vladbelous/pcb-lab-1/assembly/jlcpcb-pcb-lab-1-BOM.xlsx

Designator | Footprint | Quantity | Value | LCSC Part #
C1 | 805 | 1 | 10u | C15850
C2,C3,C4,C6,C7,C10,C11,C12,C13,C14,C15,C20,C21,C30,C31 | 603 | 15 | 100n | C14663
C5,C8 | 805 | 2 | 1u | C28323
D1 | LED_0805 | 1 | RED | C84256
D2 | LED_0805 | 1 | YEL | C2296
D3 | LED_0805 | 1 | GRN | C2297
Q30,Q31 | SOT-23-3 | 2 | NMOS_GSD | C8545
R1,R2,R3 | 805 | 3 | 1k | C17513
R4,R20 | 603 | 2 | 3.3k | C22978
R5,R6,R7,R30,R31,R32,R33 | 603 | 7 | 10k | C25804
R8,R9 | 603 | 2 | 100k | C25803
