vladbelous/pcb-lab-1/pcb-lab-1.pdf

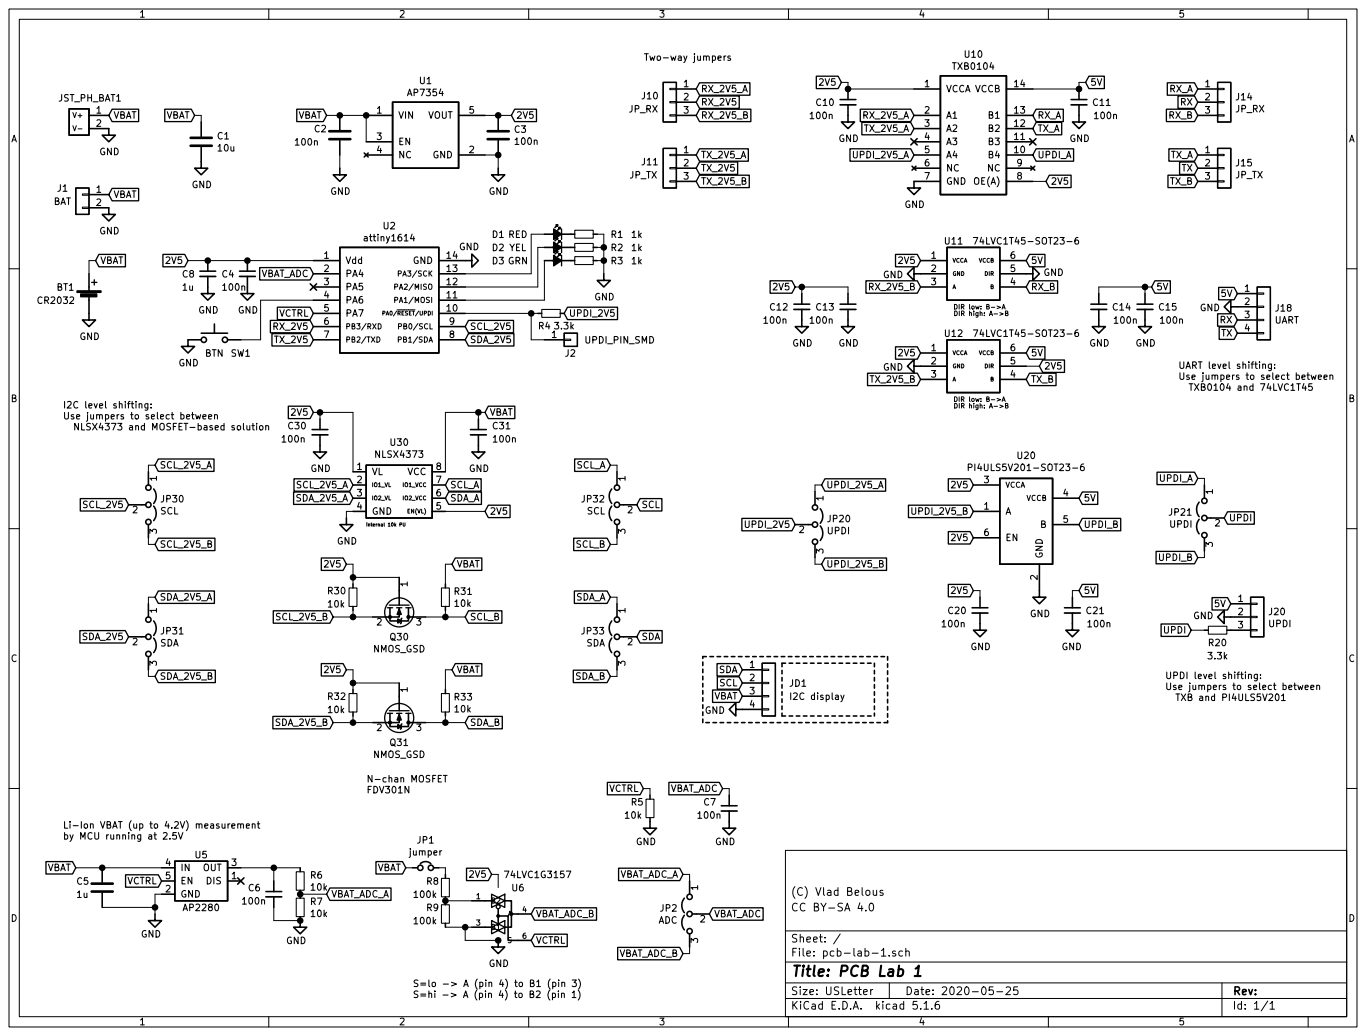
[picture p2: page 1]

DIR high: A->B DIR low: B->A

UART level shifting:
Use jumpers to select between
TXB0104 and 74LVC1T45

I2C level shifting:
NLSX4373 and MOSFET-based solution

TXB and PI4ULS5V201

S=hi -> A (pin 4) to B2 (pin 1) N-chan MOSFET
FDV301N

Li-Ion VBAT (up to 4.2V) measurement
by MCU running at 2.5V

(C) Vlad Belous File: pcb-lab-1.sch Sheet: / CC BY-SA 4.0

Rev: | D Date: 2020-05-25 KiCad E.D.A. kicad 5.1.6 Size: USLetter

Id: 1/1 Title: PCB Lab 1

S=lo -> A (pin 4) to B1 (pin 3)
