vladbelous/pcb-lab-1/pcb-lab-1.kicad_pcb

## KiCad design pcb-lab-1.kicad_pcb (2020-06-13)

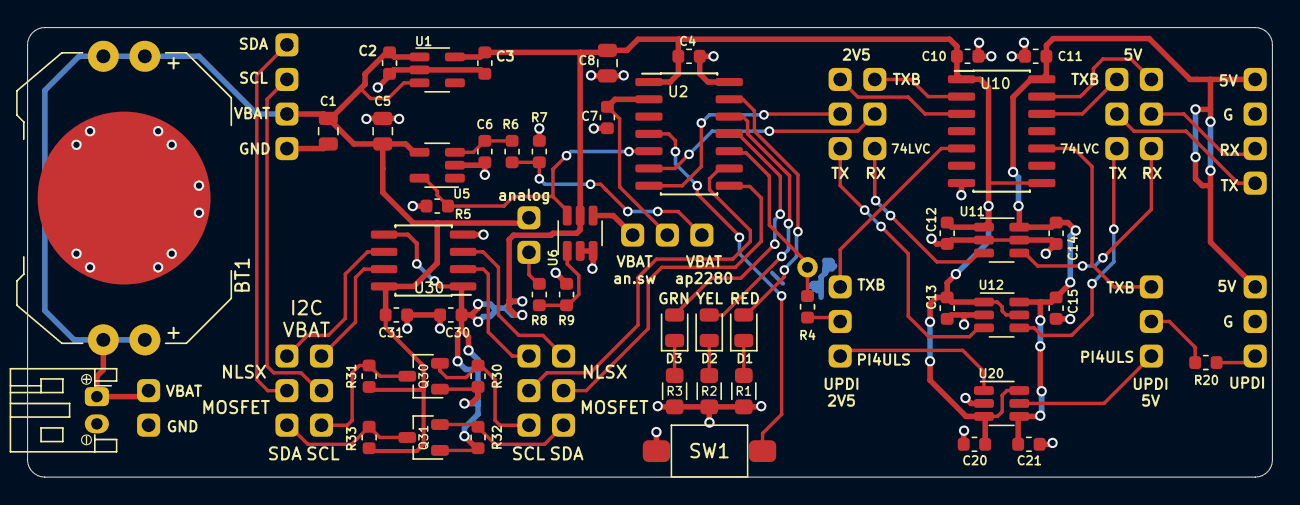
[picture p3: board pcb-lab-1.kicad_pcb from above]

Board: 2 copper layers, 91.4 x 33.0 mm, 66 parts (0 on the bottom side), 50 nets.

Parts:
BT1: CR2032; CR2032_Holder_Linx
C1: 10u; C_0805_2012Metric
C2, C3, C4, C6, C7, C10, C11, C12, C13, C14, C15, C20, C21, C30, C31: 100n; C_0603_1608Metric
C5, C8: 1u; C_0805_2012Metric
D1: RED; LED_0805_2012Metric
D2: YEL; LED_0805_2012Metric
D3: GRN; LED_0805_2012Metric
J1: BAT; Pin_Header_Straight_1x02_Pitch2.54mm
J2: UPDI_PIN_SMD; Conn_1-wire
J10, J14: JP_RX; Pin_Header_Straight_1x03_Pitch2.54mm
J11, J15: JP_TX; Pin_Header_Straight_1x03_Pitch2.54mm
J18: UART; Pin_Header_Straight_1x04_Pitch2.54mm
J20: UPDI; Pin_Header_Straight_1x03_Pitch2.54mm
JD1: I2C display; Pin_Header_Straight_1x04_Pitch2.54mm
JP1: jumper; Pin_Header_Straight_1x02_Pitch2.54mm
JP2: ADC; Pin_Header_Straight_1x03_Pitch2.54mm
JP20, JP21: UPDI; Pin_Header_Straight_1x03_Pitch2.54mm
JP30, JP32: SCL; Pin_Header_Straight_1x03_Pitch2.54mm
JP31, JP33: SDA; Pin_Header_Straight_1x03_Pitch2.54mm
JST_PH_BAT1: JST_PH_BAT; JST_PH_S2B-PH-K_02x2.00mm_Angled_WiderHole
Q30, Q31: NMOS_GSD; SOT-23_HS
R1, R2, R3: 1k; 0805_HS
R4, R20: 3.3k; R_0603_1608Metric
R5, R6, R7, R30, R31, R32, R33: 10k; R_0603_1608Metric
R8, R9: 100k; R_0603_1608Metric
SW1: BTN; SW_SPST_PUSH_6mm_3mm
U1: AP7354; SOT-23-5_HS
U2: attiny1614; SOIC-14_3.9x8.7mm_Pitch1.27mm_HS
U5: AP2280; SOT-23-5_HS
U6: 74LVC1G3157; SOT-23-6_HS
U10: TXB0104; SOIC-14_3.9x8.7mm_Pitch1.27mm_HS
U11, U12: 74LVC1T45-SOT23-6; SOT-23-6_HS
U20: PI4ULS5V201-SOT23-6; SOT-23-6_HS
U30: NLSX4373; SOIC-8_3.9x4.9mm_Pitch1.27mm_HS

Connections:
2V5: C3.1, C4.1, C8.1, C10.1, C12.1, C13.1, C20.1, C30.1, Q30.1, Q31.1, R30.1, R32.1, U1.5, U2.1, U6.5, U10.1, U10.8, U11.1, U12.1, U12.5, U20.3, U20.6, U30.1, U30.5
5V: C11.1, C14.1, C15.1, C21.1, J18.1, J20.1, U10.14, U11.6, U12.6, U20.4
GND: BT1.2, C1.2, C2.2, C3.2, C4.2, C5.2, C6.2, C7.2, C8.2, C10.2, C11.2, C12.2, C13.2, C14.2, C15.2, C20.2, C21.2, C30.2, C31.2, J1.2, J18.2, J20.2, JD1.4, JST_PH_BAT1.2, R1.1, R2.1, R3.1, R5.2, R7.2, R9.2, SW1.1, U1.2, U2.14, U5.2, U6.2, U6.3, U10.7, U11.2, U11.5, U12.2, U20.2, U30.4
unnamed: C6.1, R6.1, U5.3
unnamed: D1.1, R1.2
unnamed: D1.2, U2.13
unnamed: D2.1, R2.2
unnamed: D2.2, U2.12
unnamed: D3.1, R3.2
unnamed: D3.2, U2.11
unnamed: J2.1, R4.1, U2.10
unnamed: J20.3, R20.2
unnamed: JP1.2, R8.1
unnamed: R8.2, R9.1, U6.1
unnamed: SW1.2, U2.4
RX: J14.2, J18.3
RX_2V5: J10.2, U2.6
RX_2V5_A: J10.1, U10.2
RX_2V5_B: J10.3, U11.3
RX_A: J14.1, U10.13
RX_B: J14.3, U11.4
SCL: JD1.2, JP32.2
SCL_2V5: JP30.2, U2.9
SCL_2V5_A: JP30.1, U30.2
SCL_2V5_B: JP30.3, Q30.2, R30.2
SCL_A: JP32.1, U30.7
SCL_B: JP32.3, Q30.3, R31.2
SDA: JD1.1, JP33.2
SDA_2V5: JP31.2, U2.8
SDA_2V5_A: JP31.1, U30.3
SDA_2V5_B: JP31.3, Q31.2, R32.2
SDA_A: JP33.1, U30.6
SDA_B: JP33.3, Q31.3, R33.2
TX: J15.2, J18.4
TX_2V5: J11.2, U2.7
TX_2V5_A: J11.1, U10.3
TX_2V5_B: J11.3, U12.3
TX_A: J15.1, U10.12
TX_B: J15.3, U12.4
UPDI: JP21.2, R20.1
UPDI_2V5: JP20.2, R4.2
UPDI_2V5_A: JP20.1, U10.5
UPDI_2V5_B: JP20.3, U20.1
UPDI_A: JP21.1, U10.10
UPDI_B: JP21.3, U20.5
VBAT: BT1.1, C1.1, C2.1, C5.1, C31.1, J1.1, JD1.3, JP1.1, JST_PH_BAT1.1, R31.1, R33.1, U1.1, U1.3, U5.4, U30.8
VBAT_ADC: C7.1, JP2.2, U2.2
VBAT_ADC_A: JP2.1, R6.2, R7.1
VBAT_ADC_B: JP2.3, U6.4
VCTRL: R5.1, U2.5, U5.5, U6.6
