vladbelous/pcb-lab-1/(commit log)

2020-05-26 Project init
    [pcb-lab-1.kicad_pcb, pcb-lab-1.sch]
2020-05-26 Roughly place major components
    [pcb-lab-1.sch]
2020-05-30 Schematic ~50%: I2C shifting and UART (except Si8422)
    [pcb-lab-1.sch]
2020-05-30 Add UPDI; fixes
    [pcb-lab-1.sch]
2020-05-30 Remove Si8422 - bad supply range
    [pcb-lab-1.sch]
2020-05-31 Add AP2280 and VBAT measurement circuit
    [pcb-lab-1.sch]
2020-06-01 Add LEDs, button, etc. Finished schematic
    [pcb-lab-1.sch]
2020-06-01 Annotate schematic
    [pcb-lab-1.sch]
2020-06-01 New footprint (CR2032), symbol->footprint assignment
    [pcb-lab-1.sch]
2020-06-01 Layout: initial component arrangement
    [pcb-lab-1.kicad_pcb, pcb-lab-1.sch]
2020-06-01 Component arrangement
    [pcb-lab-1.kicad_pcb, pcb-lab-1.sch]
2020-06-06 Add analog switch as option for VBAT
    [pcb-lab-1.sch]
2020-06-06 New netlist, and approx pcb arrangement
    [pcb-lab-1.kicad_pcb]
2020-06-12 New component arrangement
    [pcb-lab-1.kicad_pcb]
2020-06-12 VBAT and I2C routing
    [pcb-lab-1.kicad_pcb]
2020-06-13 Complete routing
    [pcb-lab-1.kicad_pcb]
2020-06-13 Gerber test; Adjust silkscreen
    [pcb-lab-1-B_Cu.gbr, pcb-lab-1-B_Fab.gbr, pcb-lab-1-B_Mask.gbr, pcb-lab-1-B_Paste.gbr, pcb-lab-1-B_SilkS.gbr, pcb-lab-1-Edge_Cuts.gbr, pcb-lab-1-F_Cu.gbr, pcb-lab-1-F_Fab.gbr]
2020-06-13 Gerbers; JLCPCB-friendly BOM and pick-and-place
    [jlcpcb-pcb-lab-1-BOM.xlsx, pcb-lab-1-BOM.csv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]
2020-06-29 Add schematic PDF and png
